Tschibo00/zmk-config_ataki/kle.png

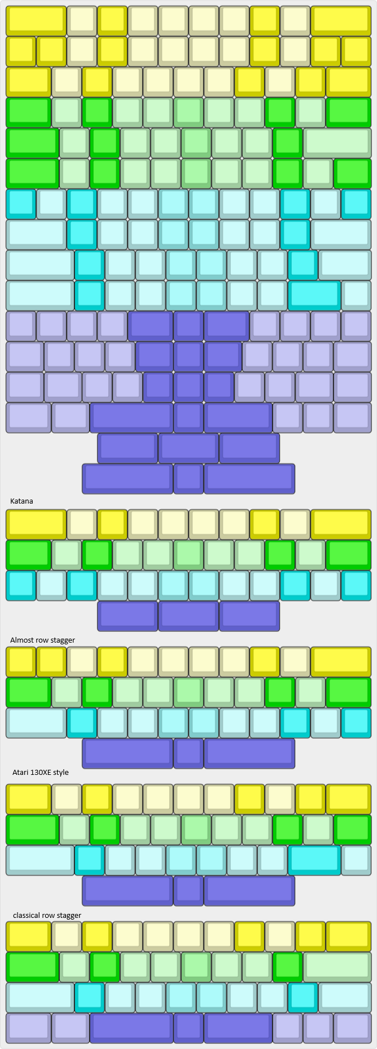
kle.png
