Tschibo00/zmk-config_ataki/boards/shields/ataki/fn-console-set-choc.stl

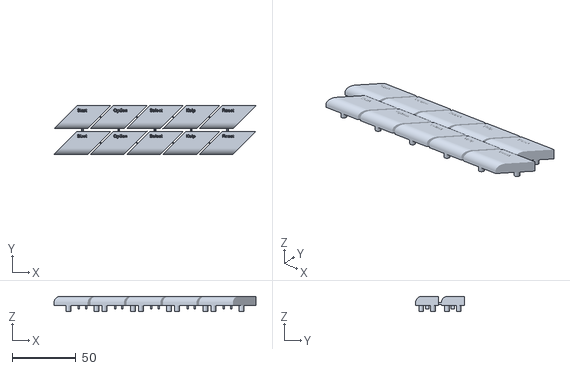
[picture p3: CAD file, 2026-03-01, last stored version]
boards/shields/ataki/fn-console-set-choc.stl
158.2 x 38.3 x 12.0
