Tschibo00/zmk-config_ataki/boards/shields/ataki/pcb/v2/atari.kicad_sch

## KiCad design boards/shields/ataki/pcb/v2/atari.kicad_sch (2026-03-01, last stored version)

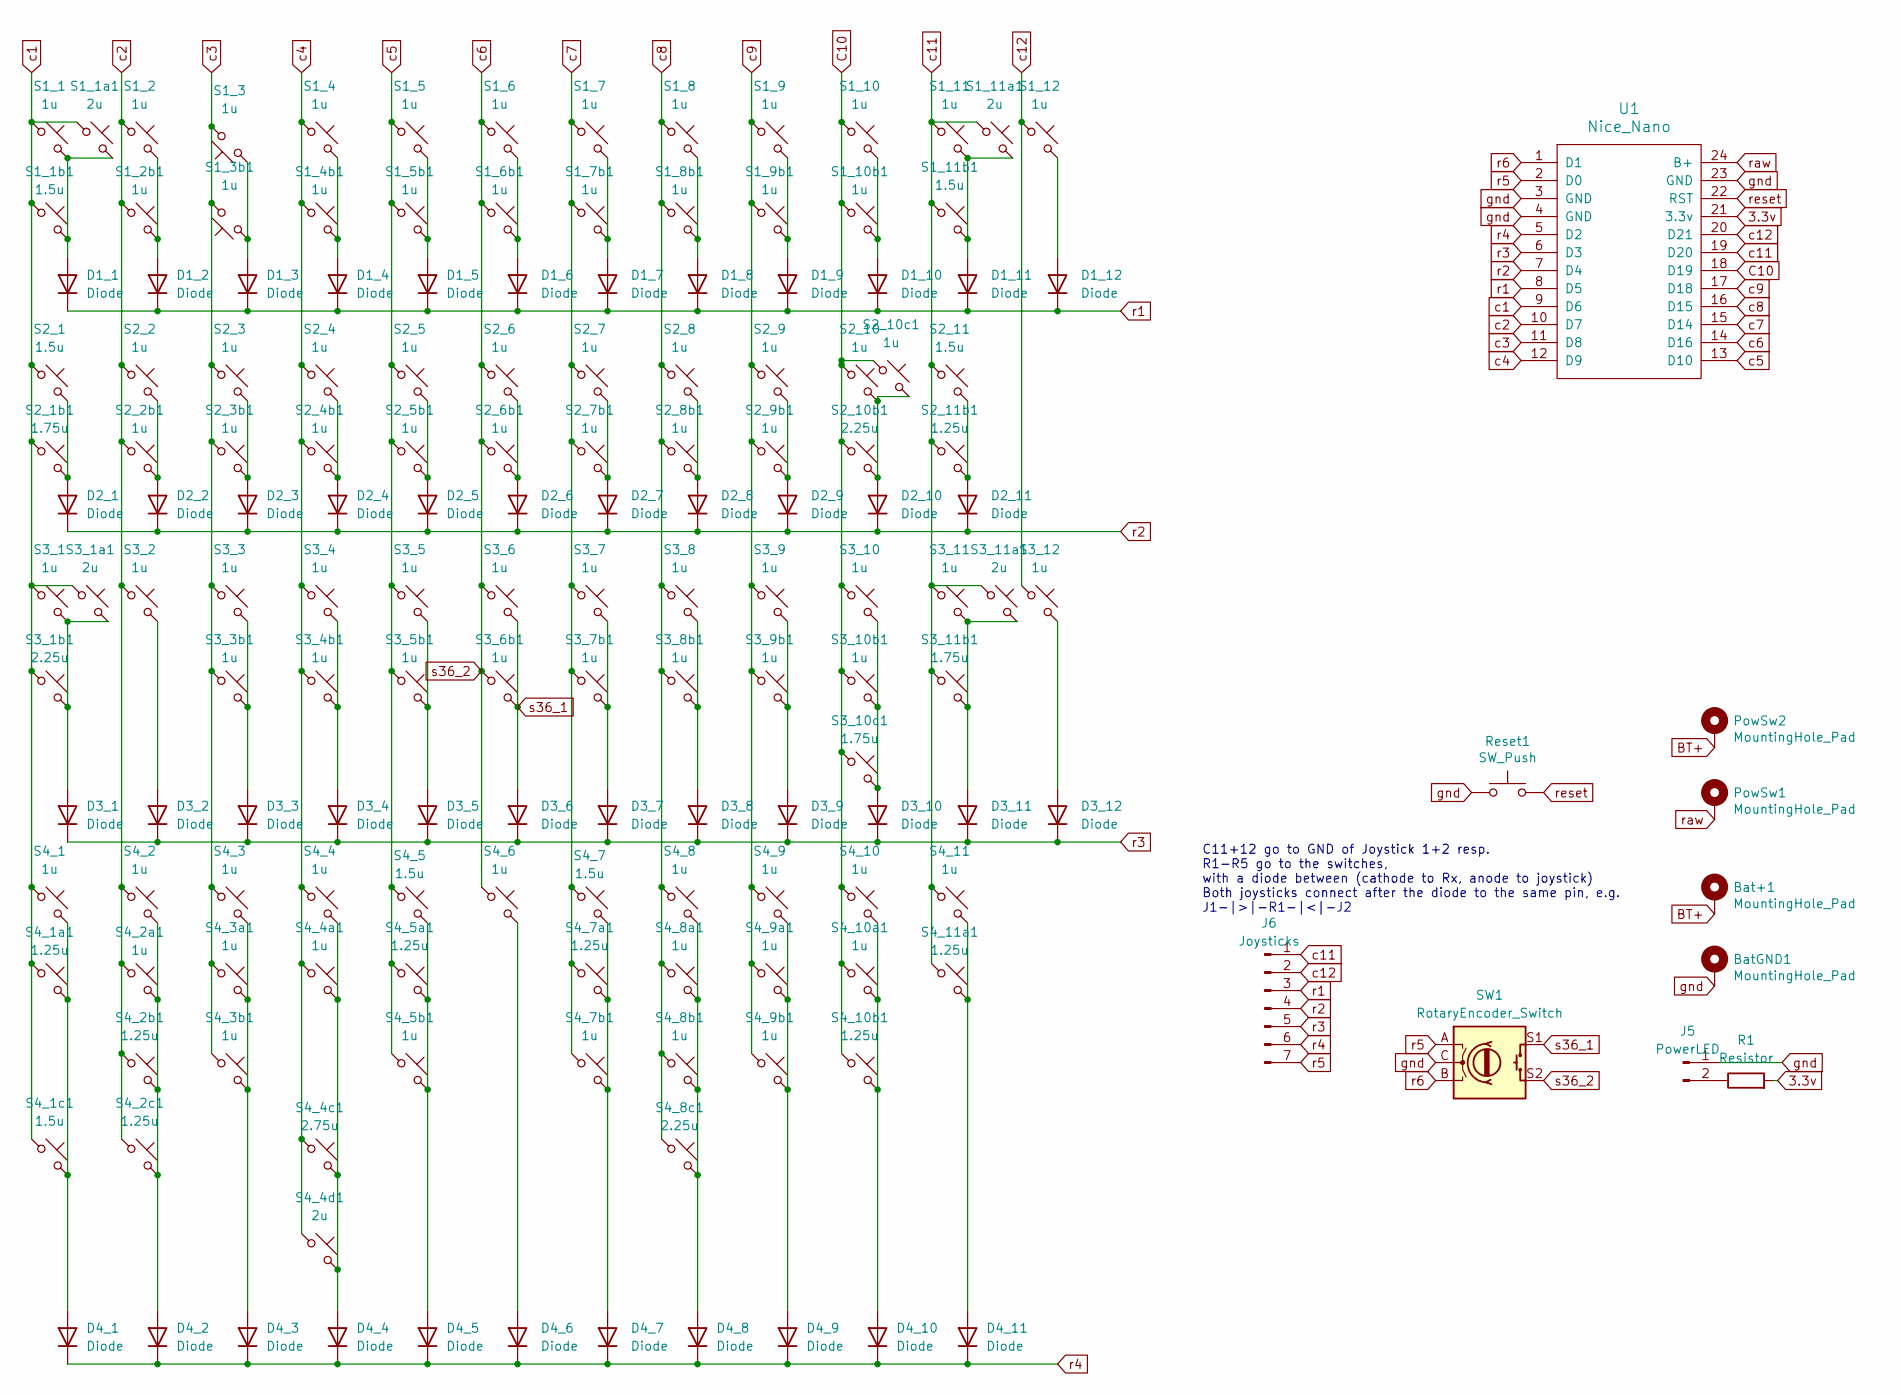
[picture p4: schematic atari.kicad_sch]

Parts:
Bat+1: MountingHole_Pad; SolderWire-0.5sqmm_1x01_D0.9mm_OD2.1mm
BatGND1: MountingHole_Pad; SolderWire-0.5sqmm_1x01_D0.9mm_OD2.1mm
D1_1, D1_2, D1_3, D1_4, D1_5, D1_6, D1_7, D1_8, D1_9, D1_10, D1_11, D1_12, D2_1, D2_2, D2_3, D2_4, D2_5, D2_6, D2_7, D2_8, D2_9, D2_10, D2_11, D3_1, D3_2, D3_3, D3_4, D3_5, D3_6, D3_7, D3_8, D3_9, D3_10, D3_11, D3_12, D4_1, D4_2, D4_3, D4_4, D4_5, D4_6, D4_7, D4_8, D4_9, D4_10, D4_11: Diode; Diode_DO-35
J5: PowerLED; PinHeader_1x02_P2.54mm_Vertical
J6: Joysticks; PinSocket_1x07_P2.00mm_Vertical
PowSw1, PowSw2: MountingHole_Pad; SolderWire-0.5sqmm_1x01_D0.9mm_OD2.1mm
R1: Resistor; R_Axial_DIN0207_L6.3mm_D2.5mm_P7.62mm_Horizontal
Reset1: SW_Push; SW_PUSH_6mm_H4.3mm
S1_1, S1_2, S1_2b1, S1_3, S1_3b1, S1_4, S1_4b1, S1_5, S1_5b1, S1_6, S1_6b1, S1_7, S1_7b1, S1_8, S1_8b1, S1_9, S1_9b1, S1_10, S1_10b1, S1_11, S1_12, S2_2, S2_2b1, S2_3, S2_3b1, S2_4, S2_4b1, S2_5, S2_5b1, S2_6, S2_6b1, S2_7, S2_7b1, S2_8, S2_8b1, S2_9, S2_9b1, S2_10, S2_10c1, S3_1, S3_2, S3_3, S3_3b1, S3_4, S3_4b1, S3_5, S3_5b1, S3_6, S3_6b1, S3_7, S3_7b1, S3_8, S3_8b1, S3_9, S3_9b1, S3_10, S3_10b1, S3_11, S3_12, S4_1, S4_2, S4_2a1, S4_3, S4_3a1, S4_3b1, S4_4, S4_4a1, S4_5b1, S4_6, S4_7b1, S4_8, S4_8a1, S4_8b1, S4_9, S4_9a1, S4_9b1, S4_10, S4_10a1, S4_11: 1u; MX_PCB_1.00u
S1_1a1, S1_11a1, S3_1a1, S3_11a1, S4_4d1: 2u; MX_PCB_2.00u_90deg
S1_1b1, S1_11b1, S2_1, S2_11, S4_1c1, S4_5, S4_7: 1.5u; MX_PCB_1.50u_90deg
S2_1b1, S3_10c1, S3_11b1: 1.75u; MX_PCB_1.75u_90deg
S2_10b1, S3_1b1, S4_8c1: 2.25u; MX_PCB_2.25u_90deg
S2_11b1, S4_1a1, S4_2b1, S4_2c1, S4_5a1, S4_7a1, S4_10b1, S4_11a1: 1.25u; MX_PCB_1.25u_90deg
S4_4c1: 2.75u; MX_PCB_2.75u_90deg
SW1: RotaryEncoder_Switch; RotaryEncoder_Alps_EC11E-Switch_Vertical_H20mm
U1: Nice_Nano; Nice_Nano_V2

Connections:
3.3v: R1.2, U1.21 (3.3v)
BT+: Bat+1.1, PowSw2.1
C10: S1_10.1, S1_10b1.1, S2_10.1, S2_10b1.1, S2_10c1.1, S3_10.1, S3_10b1.1, S3_10c1.1, S4_10.1, S4_10a1.1, S4_10b1.1, U1.18 (D19)
unnamed: D1_1.2 (A), S1_1.2, S1_1a1.2, S1_1b1.2
unnamed: D1_2.2 (A), S1_2.2, S1_2b1.2
unnamed: D1_3.2 (A), S1_3.1, S1_3b1.1
unnamed: D1_4.2 (A), S1_4.2, S1_4b1.2
unnamed: D1_5.2 (A), S1_5.2, S1_5b1.2
unnamed: D1_6.2 (A), S1_6.2, S1_6b1.2
unnamed: D1_7.2 (A), S1_7.2, S1_7b1.2
unnamed: D1_8.2 (A), S1_8.2, S1_8b1.2
unnamed: D1_9.2 (A), S1_9.2, S1_9b1.2
unnamed: D1_10.2 (A), S1_10.2, S1_10b1.2
unnamed: D1_11.2 (A), S1_11.2, S1_11a1.2, S1_11b1.2
unnamed: D1_12.2 (A), S1_12.2
unnamed: D2_1.2 (A), S2_1.2, S2_1b1.2
unnamed: D2_2.2 (A), S2_2.2, S2_2b1.2
unnamed: D2_3.2 (A), S2_3.2, S2_3b1.2
unnamed: D2_4.2 (A), S2_4.2, S2_4b1.2
unnamed: D2_5.2 (A), S2_5.2, S2_5b1.2
unnamed: D2_6.2 (A), S2_6.2, S2_6b1.2
unnamed: D2_7.2 (A), S2_7.2, S2_7b1.2
unnamed: D2_8.2 (A), S2_8.2, S2_8b1.2
unnamed: D2_9.2 (A), S2_9.2, S2_9b1.2
unnamed: D2_10.2 (A), S2_10.2, S2_10b1.2, S2_10c1.2
unnamed: D2_11.2 (A), S2_11.2, S2_11b1.2
unnamed: D3_1.2 (A), S3_1.2, S3_1a1.2, S3_1b1.2
unnamed: D3_2.2 (A), S3_2.2
unnamed: D3_3.2 (A), S3_3.2, S3_3b1.2
unnamed: D3_4.2 (A), S3_4.2, S3_4b1.2
unnamed: D3_5.2 (A), S3_5.2, S3_5b1.2
unnamed: D3_7.2 (A), S3_7.2, S3_7b1.2
unnamed: D3_8.2 (A), S3_8.2, S3_8b1.2
unnamed: D3_9.2 (A), S3_9.2, S3_9b1.2
unnamed: D3_10.2 (A), S3_10.2, S3_10b1.2, S3_10c1.2
unnamed: D3_11.2 (A), S3_11.2, S3_11a1.2, S3_11b1.2
unnamed: D3_12.2 (A), S3_12.2
unnamed: D4_1.2 (A), S4_1.2, S4_1a1.2, S4_1c1.2
unnamed: D4_2.2 (A), S4_2.2, S4_2a1.2, S4_2b1.2, S4_2c1.2
unnamed: D4_3.2 (A), S4_3.2, S4_3a1.2, S4_3b1.2
unnamed: D4_4.2 (A), S4_4.2, S4_4a1.2, S4_4c1.2, S4_4d1.2
unnamed: D4_5.2 (A), S4_5.2, S4_5a1.2, S4_5b1.2
unnamed: D4_6.2 (A), S4_6.2
unnamed: D4_7.2 (A), S4_7.2, S4_7a1.2, S4_7b1.2
unnamed: D4_8.2 (A), S4_8.2, S4_8a1.2, S4_8b1.2, S4_8c1.2
unnamed: D4_9.2 (A), S4_9.2, S4_9a1.2, S4_9b1.2
unnamed: D4_10.2 (A), S4_10.2, S4_10a1.2, S4_10b1.2
unnamed: D4_11.2 (A), S4_11.2, S4_11a1.2
unnamed: J5.2, R1.1
c1: S1_1.1, S1_1a1.1, S1_1b1.1, S2_1.1, S2_1b1.1, S3_1.1, S3_1a1.1, S3_1b1.1, S4_1.1, S4_1a1.1, S4_1c1.1, U1.9 (D6)
c2: S1_2.1, S1_2b1.1, S2_2.1, S2_2b1.1, S3_2.1, S4_2.1, S4_2a1.1, S4_2b1.1, S4_2c1.1, U1.10 (D7)
c3: S1_3.2, S1_3b1.2, S2_3.1, S2_3b1.1, S3_3.1, S3_3b1.1, S4_3.1, S4_3a1.1, S4_3b1.1, U1.11 (D8)
c4: S1_4.1, S1_4b1.1, S2_4.1, S2_4b1.1, S3_4.1, S3_4b1.1, S4_4.1, S4_4a1.1, S4_4c1.1, S4_4d1.1, U1.12 (D9)
c5: S1_5.1, S1_5b1.1, S2_5.1, S2_5b1.1, S3_5.1, S3_5b1.1, S4_5.1, S4_5a1.1, S4_5b1.1, U1.13 (D10)
c6: S1_6.1, S1_6b1.1, S2_6.1, S2_6b1.1, S3_6.1, S3_6b1.1, S4_6.1, SW1.S2, U1.14 (D16)
c7: S1_7.1, S1_7b1.1, S2_7.1, S2_7b1.1, S3_7.1, S3_7b1.1, S4_7.1, S4_7a1.1, S4_7b1.1, U1.15 (D14)
c8: S1_8.1, S1_8b1.1, S2_8.1, S2_8b1.1, S3_8.1, S3_8b1.1, S4_8.1, S4_8a1.1, S4_8b1.1, S4_8c1.1, U1.16 (D15)
c9: S1_9.1, S1_9b1.1, S2_9.1, S2_9b1.1, S3_9.1, S3_9b1.1, S4_9.1, S4_9a1.1, S4_9b1.1, U1.17 (D18)
c11: J6.1, S1_11.1, S1_11a1.1, S1_11b1.1, S2_11.1, S2_11b1.1, S3_11.1, S3_11a1.1, S3_11b1.1, S4_11.1, S4_11a1.1, U1.19 (D20)
c12: J6.2, S1_12.1, S3_12.1, U1.20 (D21)
gnd: BatGND1.1, J5.1, Reset1.1, SW1.C, U1.3 (GND), U1.4 (GND), U1.23 (GND)
r1: D1_1.1 (K), D1_2.1 (K), D1_3.1 (K), D1_4.1 (K), D1_5.1 (K), D1_6.1 (K), D1_7.1 (K), D1_8.1 (K), D1_9.1 (K), D1_10.1 (K), D1_11.1 (K), D1_12.1 (K), J6.3, U1.8 (D5)
r2: D2_1.1 (K), D2_2.1 (K), D2_3.1 (K), D2_4.1 (K), D2_5.1 (K), D2_6.1 (K), D2_7.1 (K), D2_8.1 (K), D2_9.1 (K), D2_10.1 (K), D2_11.1 (K), J6.4, U1.7 (D4)
r3: D3_1.1 (K), D3_2.1 (K), D3_3.1 (K), D3_4.1 (K), D3_5.1 (K), D3_6.1 (K), D3_7.1 (K), D3_8.1 (K), D3_9.1 (K), D3_10.1 (K), D3_11.1 (K), D3_12.1 (K), J6.5, U1.6 (D3)
r4: D4_1.1 (K), D4_2.1 (K), D4_3.1 (K), D4_4.1 (K), D4_5.1 (K), D4_6.1 (K), D4_7.1 (K), D4_8.1 (K), D4_9.1 (K), D4_10.1 (K), D4_11.1 (K), J6.6, U1.5 (D2)
r5: J6.7, SW1.A, U1.2 (D0)
r6: SW1.B, U1.1 (D1)
raw: PowSw1.1, U1.24 (B+)
reset: Reset1.2, U1.22 (RST)
s36_1: D3_6.2 (A), S3_6.2, S3_6b1.2, SW1.S1

Notes on the sheet:
C11+12 go to GND of Joystick 1+2 resp. R1-R5 go to the switches, with a diode between (cathode to Rx, anode to joystick) Both joysticks connect after the diode to the same pin, e.g. J1-|>|-R1-|<|-J2
