Tschibo00/zmk-config_ataki/(commit log)

2026-03-01 using correct board
    [atari.kicad_sch, fn-console-set-choc.stl]
2026-03-01 removing other boards from build
2026-03-01 adding encoder support
2026-03-01 moving encoder support to katana
2026-03-01 adjust encoder settings
2026-03-01 removig encoder debug again
2026-03-01 debug encoder pgupdwn
2026-03-03 moving inc to boards; fixing wrong mappings on katana
2026-03-06 fixing sensor level
2026-08-09 switch form leader to sticky
2026-10-08 Update ataki.overlay to include console settings
    Added console configuration for CDC ACM UART.
2026-10-10 Fix board entry in build.yaml
2026-10-14 Add todos for fixing PCB
2026-10-15 Revise joystick connection and add function board connector
    Updated the joystick connection fix and added function board connector to PCB.
